Shaurya-Ashu/C116/README.md

<div align="center">
<h1>C116</h1><br>
  
A tiny tine MCU. It is powered by STM 32F0 micro controller and offers a built-in ToF sensor , 2 x 2 RGB matrix , 3 GPIO's & UART all under a USB-C connector. <br>





<br>

Flowers
</div>
<br>

# Zine 
Frame 4-2

# why I build it
Because it's amazing, just imagine a tiny board of approximately 1 cm x 1 cm can fit STM32 powered dev board.
and also I love making small things and I always wanted to build a tiny MCU. It has so much functionality and it's fully open source so anyone can alter it to their requirement and build their own dev board around it.

# parts & schematic
I've chosen STM32F042T6Y6TR as the brain of this project , as it offer two of the most important thing I needed for this project i.e. the size (2.6 x 2.7mm) & it offers USB interface .
It comes in a pakage of WLCSP36 and offers 36 ball pins arrange in a matrix of 6 by 6 with pitch of 0.4mm.
With flash memories of 32 Kbytes and an internal clock for usb make it even greater choice for this project .

Screenshot 2026-06-17 at 3 08 22 AM

Now for power/programing & also the thing which will decides the pcb size USB-C connector
I used a 16 pin SMD USB-C connector .

Screenshot 2026-06-17 at 3 08 38 AM

The STM32F04X reqires 3.3v to operate so i used a 3.3v @300mah LDO from texes industries i.e. TLV74333PDQNR
in a pakage size of 1mm by 1mm with two 1uf caps , one at the input and other at the output .

Screenshot 2026-06-17 at 3 08 50 AM

I have integrated a ToF (Time of Flight) sensor VL53L0X from ST and it comes in a pakage size of 4.4 x 2.4 mm
With capability of accurate reading up to 2 m. 
This opens a large number of future projects which could be made with this tiny MCU(C116)

Screenshot 2026-06-17 at 3 09 12 AM

There is also a 2 x 2 matrix of RGB LEDs with support for WS2812B protocols.
It comes in a package of 1 BY 1 mm.

Screenshot 2026-06-17 at 3 09 20 AM

For extra pins i have designed some custom footprints according to the PCB dimensions and integrated seven pins in total, which are 3x GPIO's , UART, VCC & GND.

Screenshot 2026-06-17 at 3 09 48 AM

There are two tiny push buttons for reset and boot .

Screenshot 2026-06-17 at 3 09 34 AM

# PCB 

It is a 4-layer PCB designed around a footprint of the USB-C connector with dimensions of 12.4 MM by 9.4 MM
Top layer - signals
Inner layer 1 - GND
Inner layer 2 - VCC
Bottom layer - signals

Screenshot 2026-06-17 at 3 29 42 AM

Screenshot 2026-06-17 at 3 29 53 AM

Screenshot 2026-06-17 at 3 28 11 AM

Screenshot 2026-06-17 at 3 28 39 AM

# 3D rendering

Untitled_2026-Jun-16_10-40-27PM-000_CustomizedView14234716663_png_alpha
Untitled_2026-Jun-16_10-39-49PM-000_CustomizedView3308345888_png_alpha
Untitled v5 Background Removed
Untitled_2026-Jun-16_10-36-46PM-000_CustomizedView8354566009_png_alpha

# PCB ordering
It is a HDI PCB so it required some special tuning before ordering
Trace width is 0.1mm/4mil
Via size is 0.25mm OD & 0.1MM ID
Via should be filled and caped

# Firmware
To upload a code through USB-C we need to bring it in DUF mode and to do so hold the boot button and then press the reset button for a few seconds and release the reset button and then release the boo button , it will bring our MCU into DUF mode.

Use STM32CubeProgrammer for uploding the files .
