Shaurya-Ashu/C116/IMG/BOTTOM_LAYER.png

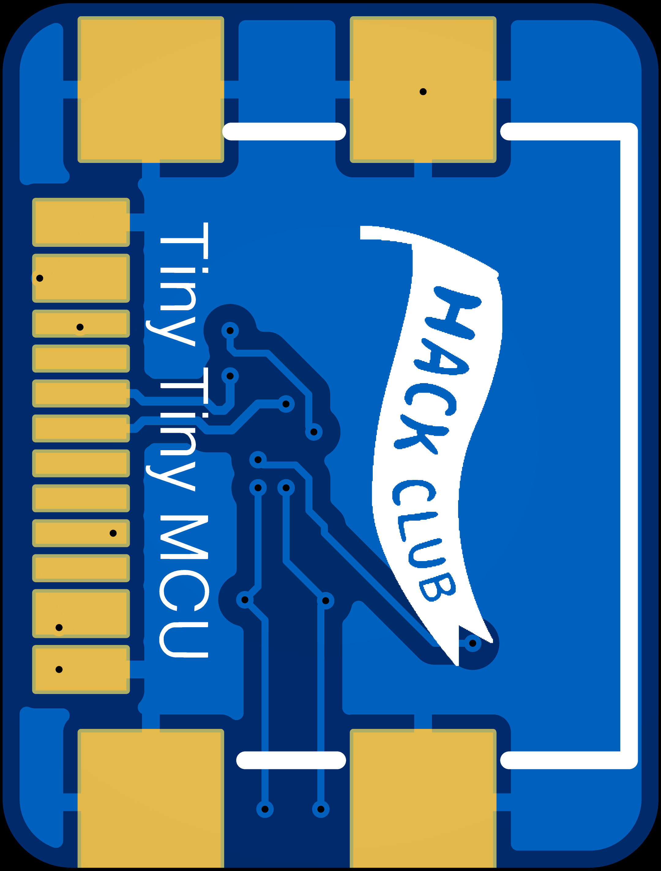
IMG/BOTTOM_LAYER.png
