Shaurya-Ashu/C116/IMG/TOP_LAYER.png

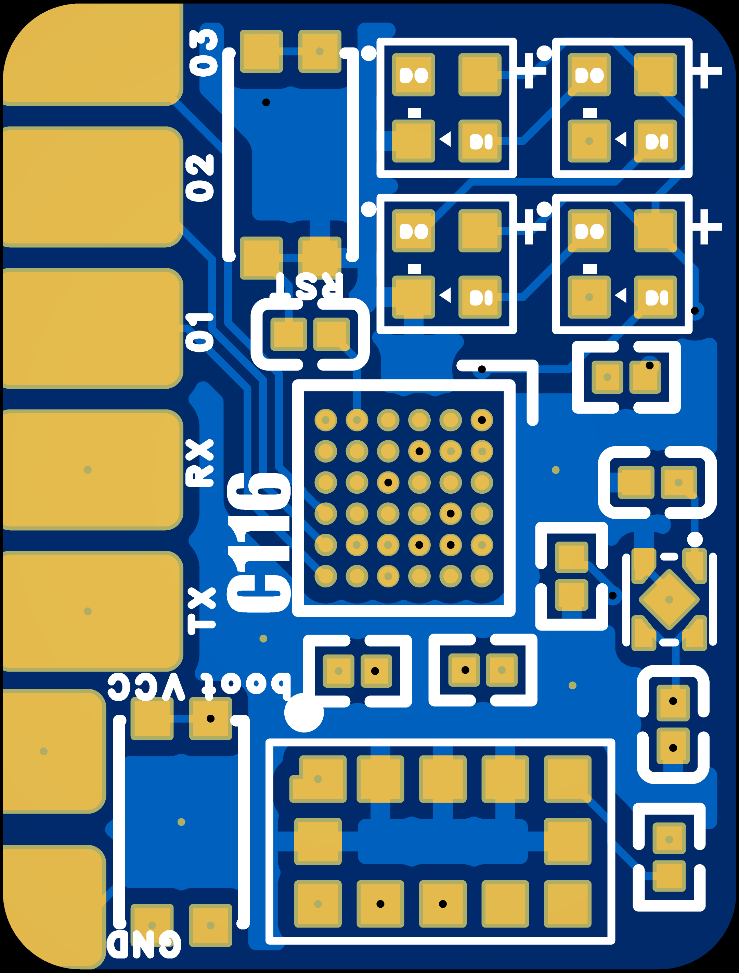
IMG/TOP_LAYER.png
