Shaurya-Ashu/C116/IMG/Untitled v4.png

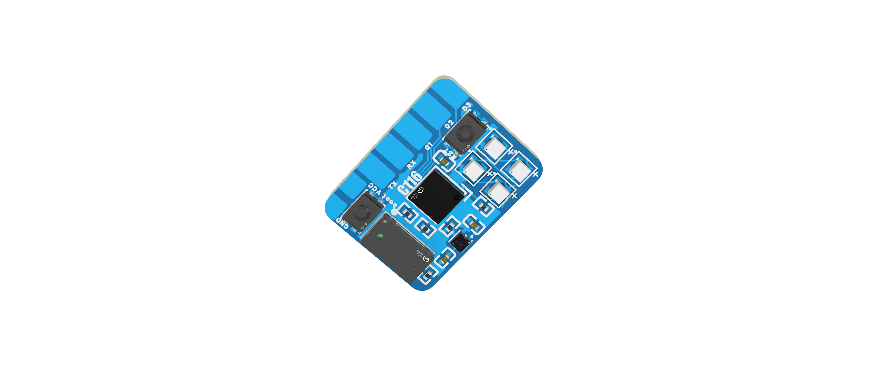
IMG/Untitled v4.png
