Shaurya-Ashu/C116/IMG/Untitled v5 Background Removed.png

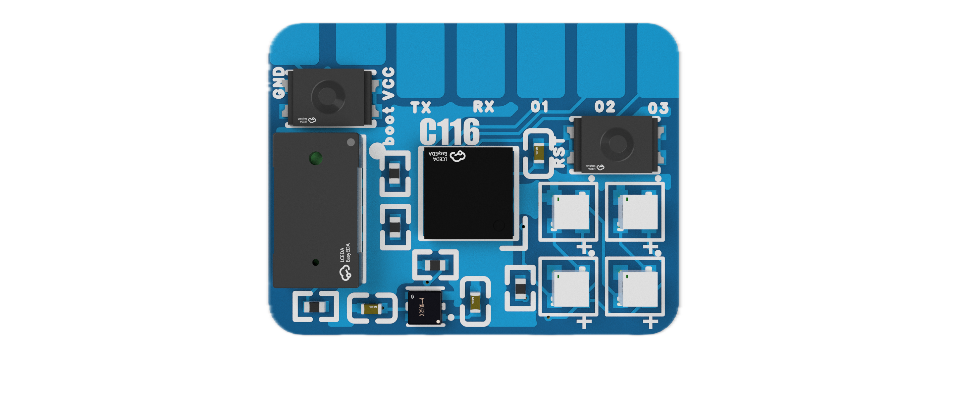
IMG/Untitled v5 Background Removed.png
