Shaurya-Ashu/C116/IMG/Untitled_2026-Jun-16_10-39-24PM-000_CustomizedView52738286545_png_alpha.png

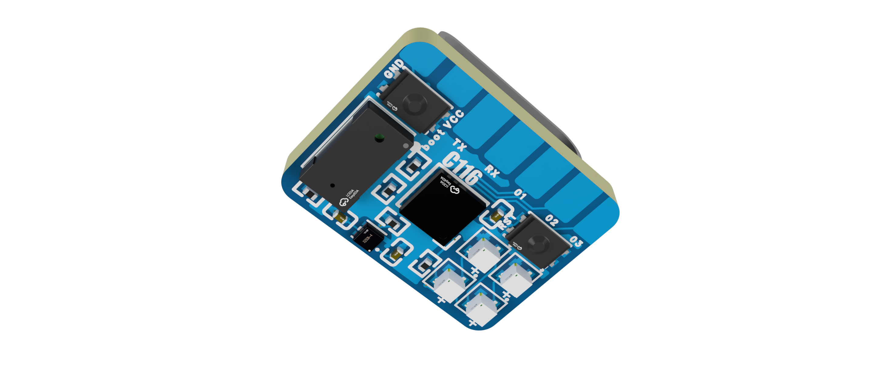
IMG/Untitled_2026-Jun-16_10-39-24PM-000_CustomizedView52738286545_png_alpha.png
