Shaurya-Ashu/C116/IMG/Untitled_2026-Jun-16_10-40-27PM-000_CustomizedView14234716663_png_alpha.png

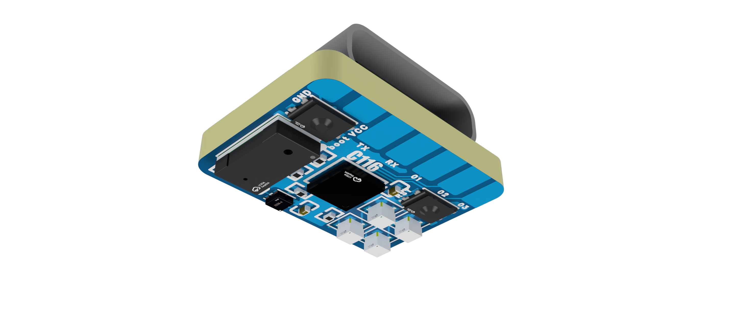
IMG/Untitled_2026-Jun-16_10-40-27PM-000_CustomizedView14234716663_png_alpha.png
