Shaurya-Ashu/C116/Production/C116_BOM.csv

No. | Quantity | Comment | Designator | Footprint | Value | Manufacturer Part | Manufacturer | Supplier Part | Supplier | LCSC Price | JLCPCB Price
1 | 2 | 1uF | C1,C3 | C0201 | 1uF | 0201X105M6R3CT | Walsin(华新科) | C295898 | LCSC |  | 0.002
2 | 1 | 100nF | C2 | C0201 | 100nF | GRM033C71C104KE14J | muRata(村田) | C2184667 | LCSC |  | 0.0014
3 | 1 | 1kΩ | R1 | R0201 | 1kΩ | CR0201JH0102G | LIZ(丽智电子) | C100150 | LCSC |  | 0.0002
4 | 2 | 2kΩ | R2,R3 | R0201 | 2kΩ | CR0201JH0202G | LIZ(丽智电子) | C100158 | LCSC |  | 0.0002
5 | 2 | 5.1kΩ | R4,R5 | R0201 | 5.1kΩ | RC0201JR-075K1L | YAGEO(国巨) | C163490 | LCSC |  | 0.0004
6 | 2 | GT-TC194A-H0055-L1 | SW1,SW2 | SW-SMD_4P-L2.5-W1.6-LS2.9_STI-055A12AX |  | GT-TC194A-H0055-L1 | G-Switch(品赞) | C41398745 | LCSC |  | 0.0228
7 | 1 | STM32F042T6Y6TR | U1 | WLCSP-36_L2.7-W2.6-R-C6-P0.40-BL |  | STM32F042T6Y6TR | ST(意法半导体) | C2054374 | LCSC |  | 0.8271
8 | 1 | TLV74333PDQNR | U2 | X2SON-4_L1.0-W1.0-P0.65-TL-EP |  | TLV74333PDQNR | TI(德州仪器) | C469880 | LCSC |  | 0.0146
9 | 1 | VL53L0X | U3 | LGA-12_L4.4-W2.4_VL53L0X |  | VL53L0X |  | C2929940 | LCSC |  | 0.0002
10 | 4 | XL-1010RGBC-2812B | U4,U5,U6,U7 | LED-SMD_4P-L1.0-W1.0-TL_XL-1010RGBC-WS2812B |  | XL-1010RGBC-2812B | XINGLIGHT(成兴光) | C5349953 | LCSC |  | 0.0112
11 | 1 | pad's for tiny mcu | U8 | PAD'S |  |  |  |  |  | 1.6109
12 | 1 | POWER PAD'S | U9 | POWER PADS |  |  |  |  |  | 1.6109
13 | 1 | GT-USB-7047A | USB1 | USB-C-SMD_GT-USB-7047A |  | GT-USB-7047A | G-Switch(品赞) | C963216 | LCSC |  | 0.0419
