Shaurya-Ashu/C116/Zine/Frame 4.pdf

# Tine Tiny MCU

C116

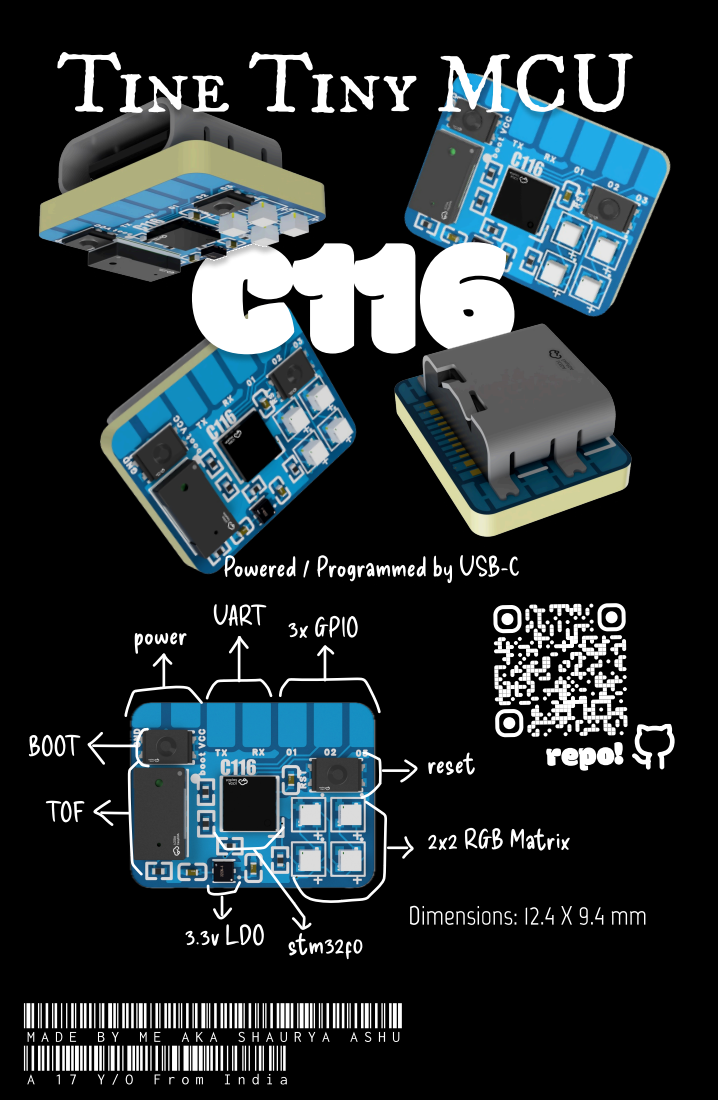
[picture p7: page 1]
power; repo! rese t; 2x2 RGB Matrix; BOOT; TOF

Powered / Programmed by USB-C
UART 3x GPIO

Dimensions: 12.4 X 9.4 mm 3.3v LDO stm32f0

MADE BY ME AKA SHAURYA ASHU
A 17 Y/O From India
