Shaurya-Ashu/C116/(list of files, drawings)

Other design files:
PCB/C116.epro
