Shaurya-Ashu/C116/(notices)

Notices in the files:
README.md:
[]([https://ohwr.org/cern_ohl_s_v2](https://spdx.org/licenses/CERN-OHL-S-2.0.html))
